StevenCoral/neato_xv/neato_navigation/maps/living_room_closed.png

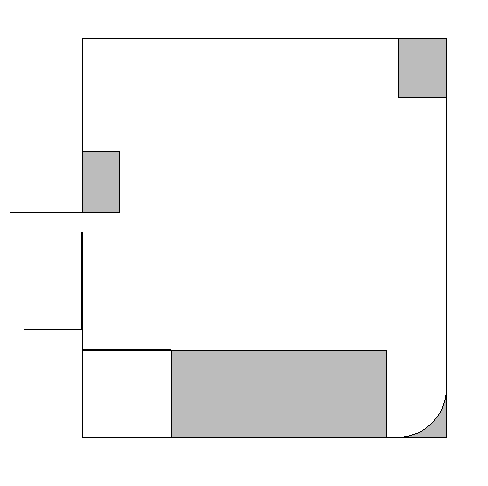
neato_navigation/maps/living_room_closed.png
