StevenCoral/neato_xv/neato_description/urdf/meshes/neatoWheel.SLDPRT

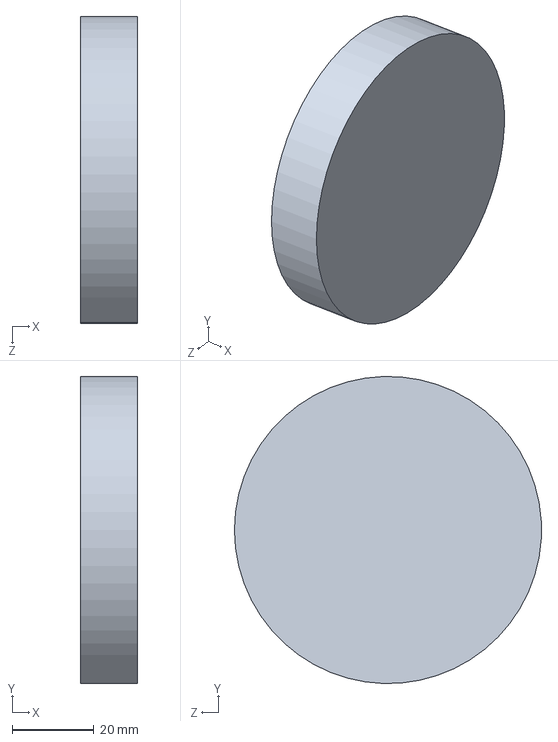
[picture p8: CAD file, 2020-06-07]
neato_description/urdf/meshes/neatoWheel.SLDPRT
14.0 x 75.0 x 75.0 mm
