StevenCoral/neato_xv/neato_description/urdf/meshes/neatoXV14.SLDPRT

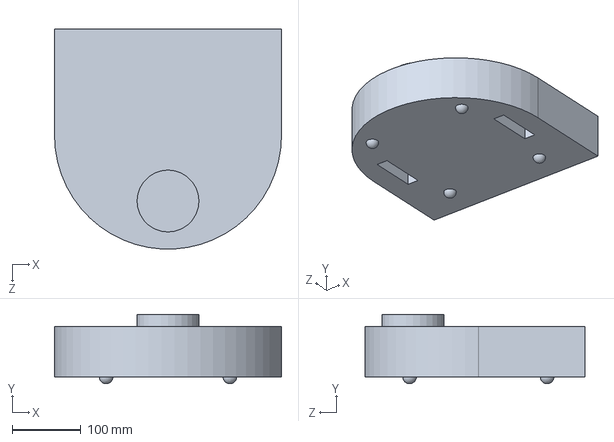
[picture p9: CAD file, 2020-06-07]
neato_description/urdf/meshes/neatoXV14.SLDPRT
330.0 x 101.0 x 319.7 mm
