StevenCoral/neato_xv/(list of files, cad)

Other CAD files:
neato_description/urdf/meshes/neato_wheel.stl
neato_description/urdf/meshes/neato_xv_14.stl
