StevenCoral/neato_xv/(commit log)

2020-06-07 Initial commit of data to push
    [model.sdf, neatoWheel.SLDPRT, neatoXV14.SLDPRT, neato_kinect.urdf, neato_real_laser.urdf, neato_wheel.stl, neato_xv_14.stl]
2020-06-08 Verified complete simulation
    [neato_real.urdf, neato_simulation.urdf]
2020-06-10 Verified lidar drivers, differential drive controller, master/slave connection
2020-06-10 Verified wheel PID control and other values, went through dwa planner params.
